Sam-Belliveau/fast-robots/README.md

# fast-robots
Website for hosting the lab assignments for ECE 4160 Fast Robots
