Sam-Belliveau/fast-robots/index.markdown

---
layout: home
title: Home
---

# ECE 4160: Fast Robots

<div style="display: flex; align-items: center; gap: 2rem; flex-wrap: wrap; margin-bottom: 1.5rem;">
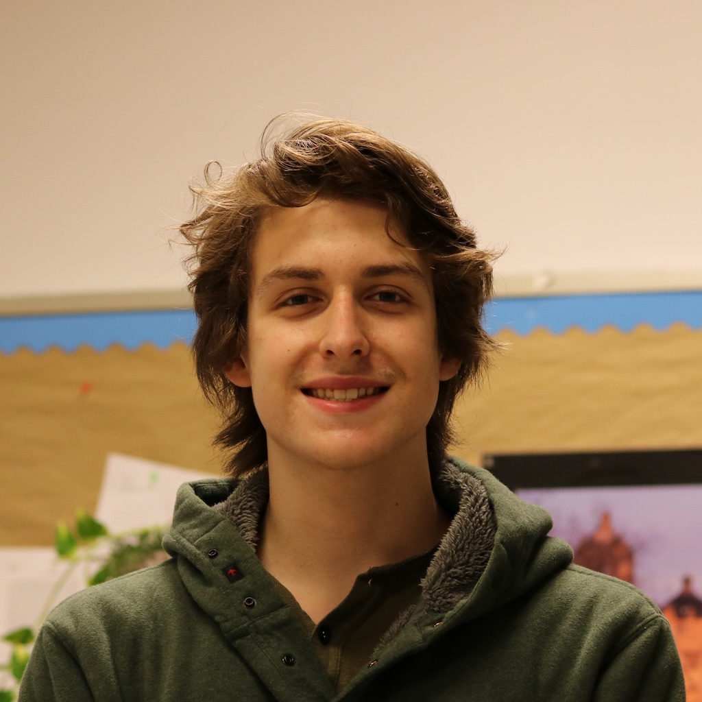
[picture p1: photos/SamBProfilePicture.jpg]
Sam Belliveau
  
  <div>
    <h2 style="margin: 0;">Sam Belliveau</h2>
    <p style="margin: 0.5rem 0;">Senior, Electrical & Computer Engineering</p>
    <p style="margin: 0;">Cornell University · Spring 2026</p>
  </div>
</div>

I'm a senior ECE major at Cornell doing HCI research. This site documents my journey through ECE 4160: Fast Robots, where I'm building and programming an autonomous robot.

🔗 **Personal Website:** [samb.nyc](https://samb.nyc)

## Labs

- [Lab 1: The Artemis Board and Bluetooth](labs/lab1/)
- [Lab 2: IMU](labs/lab2/)
- [Lab 3: ToF](labs/lab3/)
- [Lab 4: Motor Drivers and Open Loop Control](labs/lab4/)
- [Lab 5: Linear PID and Linear Interpolation](labs/lab5/)
- [Lab 6: Orientation PID](labs/lab6/)
- [Lab 7: Kalman Filtering](labs/lab7/)
- [Lab 8: Stunts!](labs/lab8/)
- [Lab 9: Mapping](labs/lab9/)
- [Lab 10: Localization (sim)](labs/lab10/)
- [Lab 11: Localization (real)](labs/lab11/)
- [Lab 12: Planning and Execution](labs/lab12/)

<!--
  -->
