Sam-Belliveau/fast-robots/labs/lab1/images/send_2_ints_ipynb.png

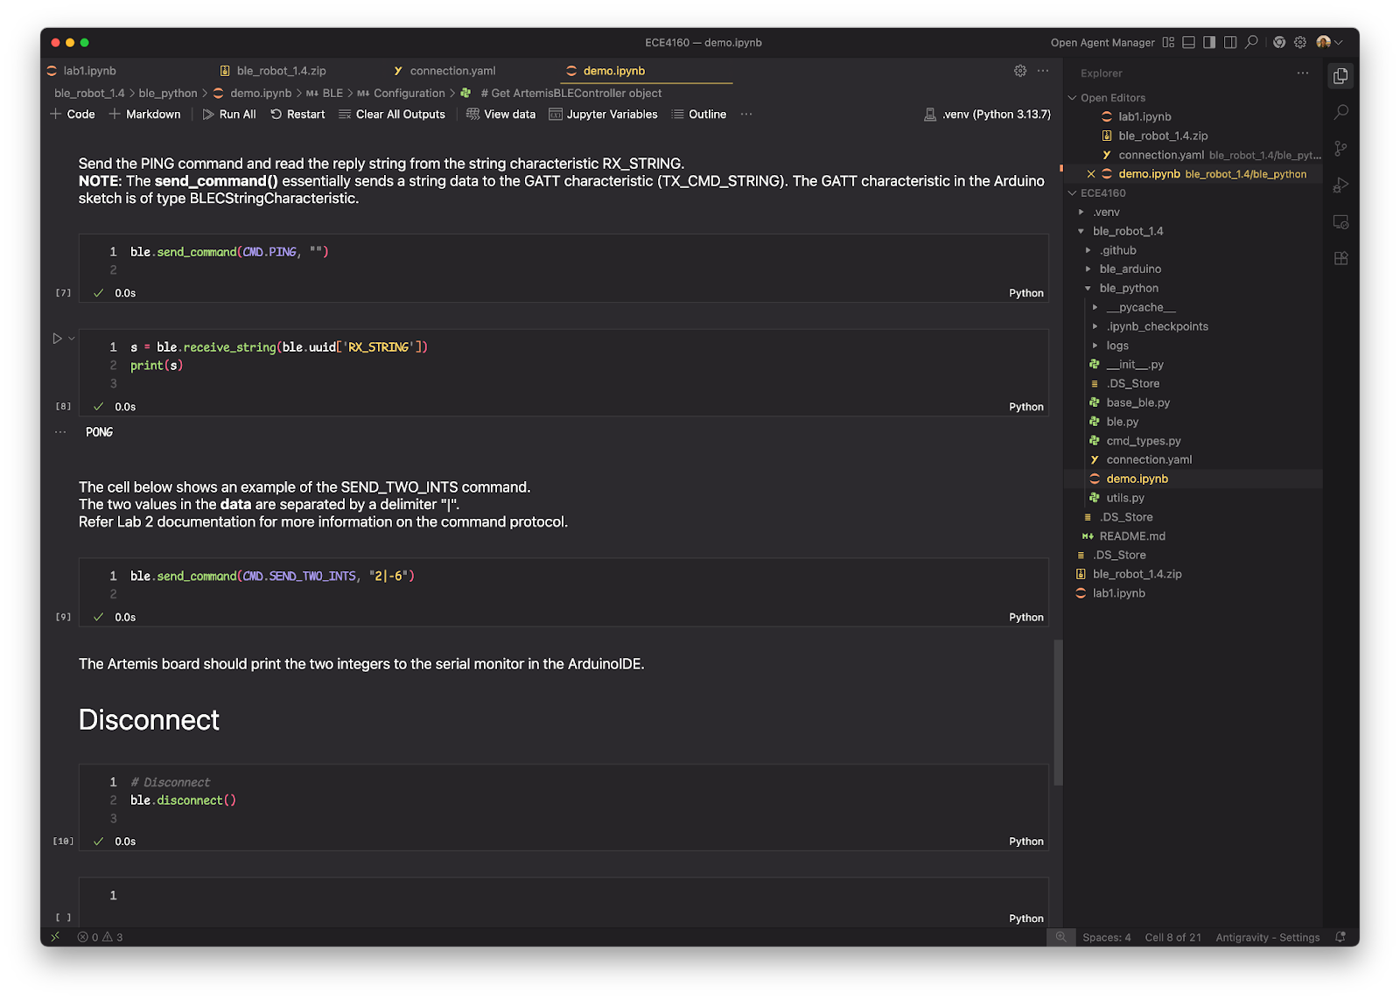
labs/lab1/images/send_2_ints_ipynb.png
