Sam-Belliveau/fast-robots/labs/lab3/images/tof_accuracy.png

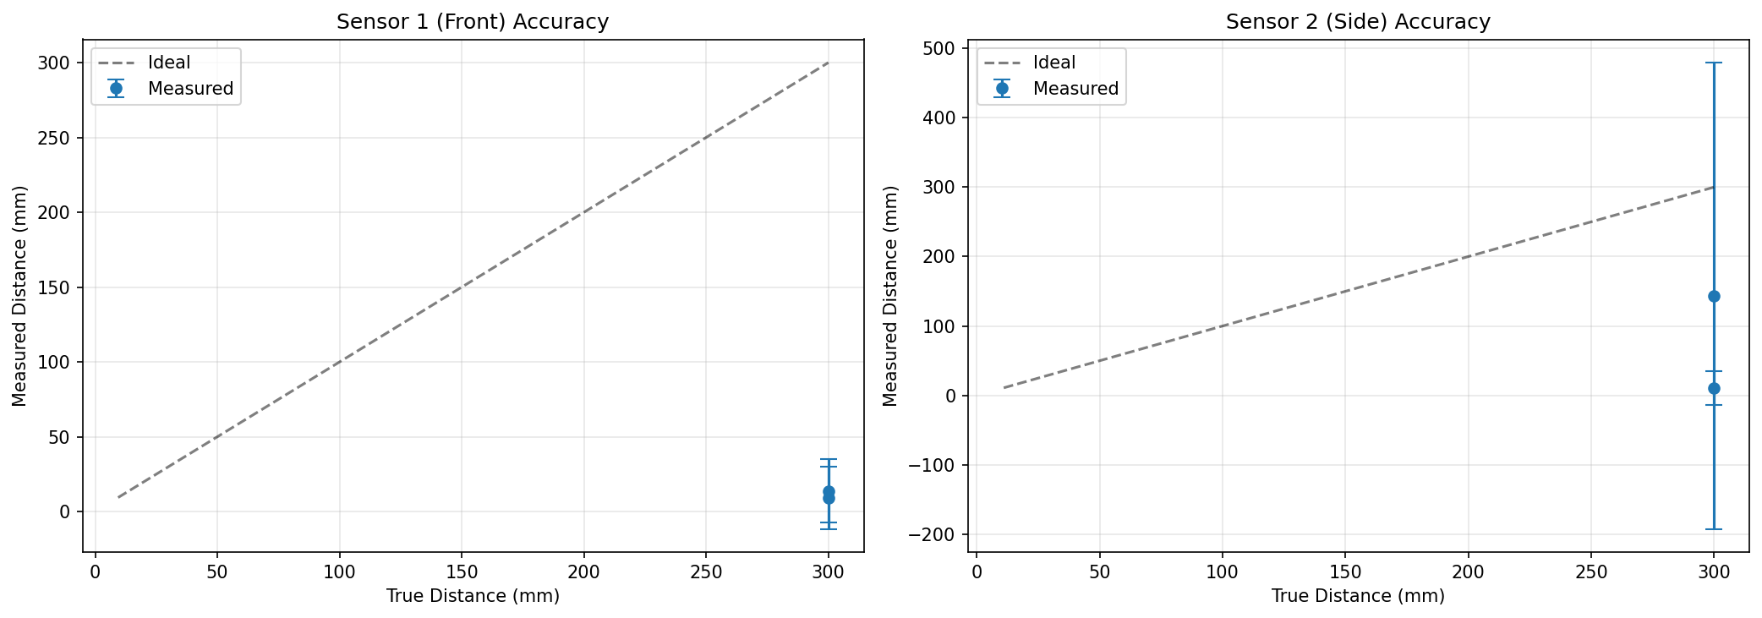
labs/lab3/images/tof_accuracy.png
