Sam-Belliveau/fast-robots/labs/lab3/images/tof_imu_combined.png

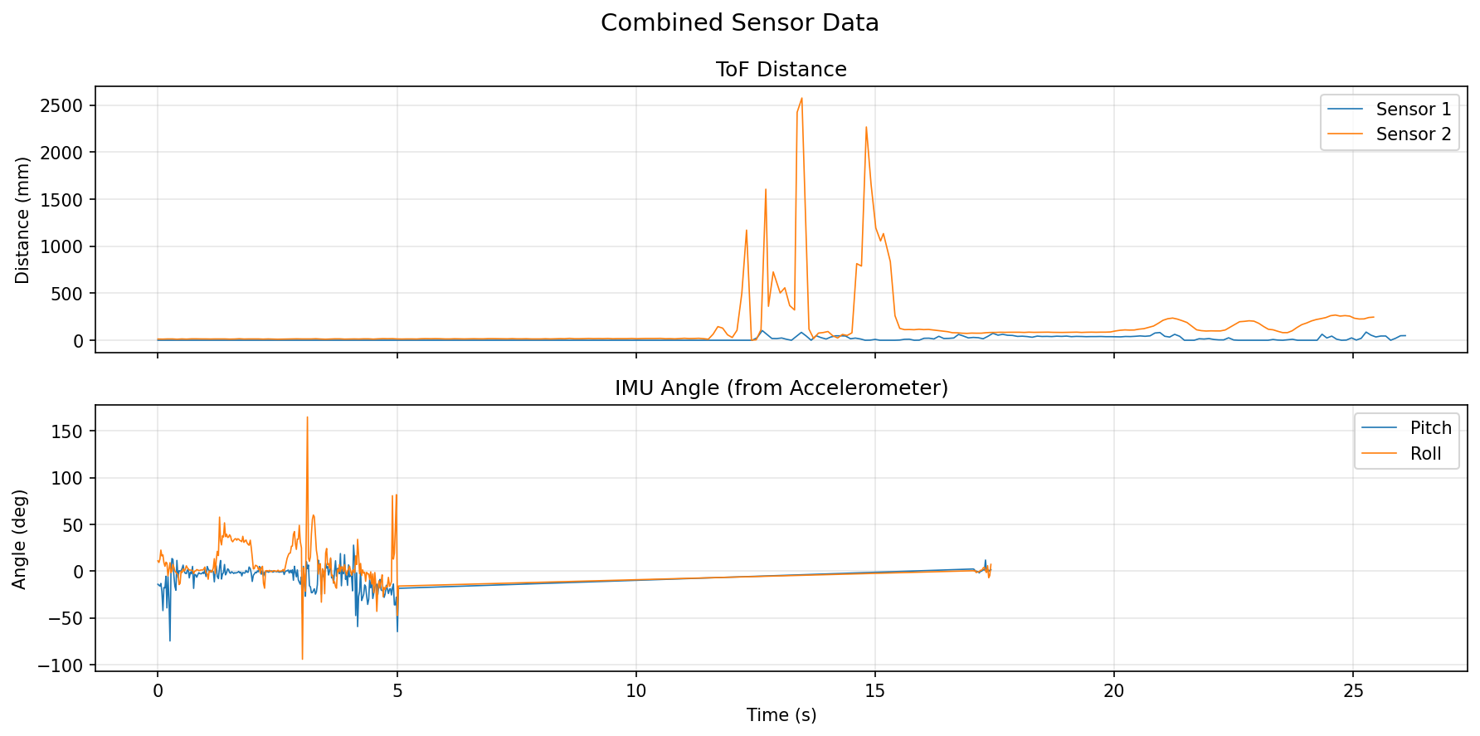
labs/lab3/images/tof_imu_combined.png
