Sam-Belliveau/fast-robots/labs/lab9/images/AngleMap1.png

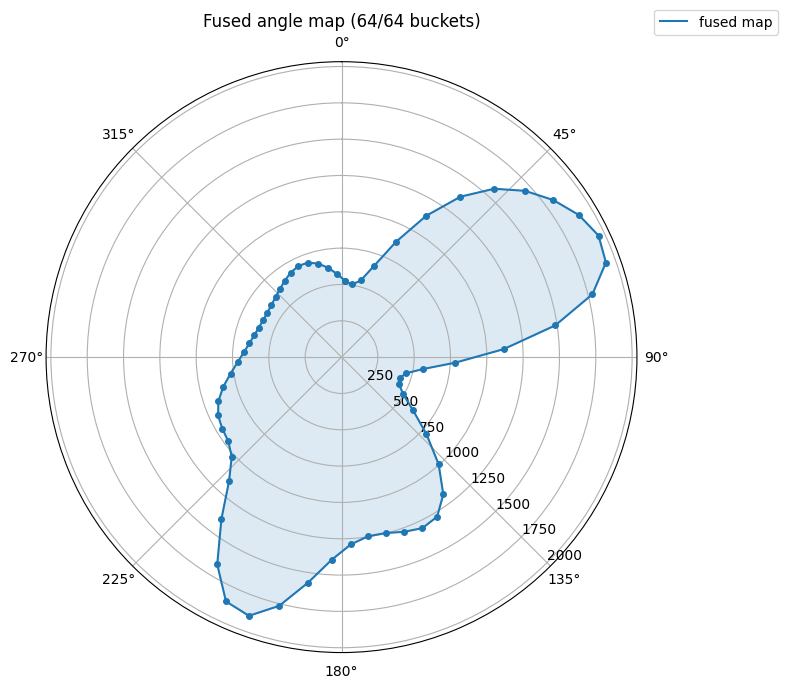
labs/lab9/images/AngleMap1.png
