Sam-Belliveau/fast-robots/labs/lab9/images/AngleMap2.png

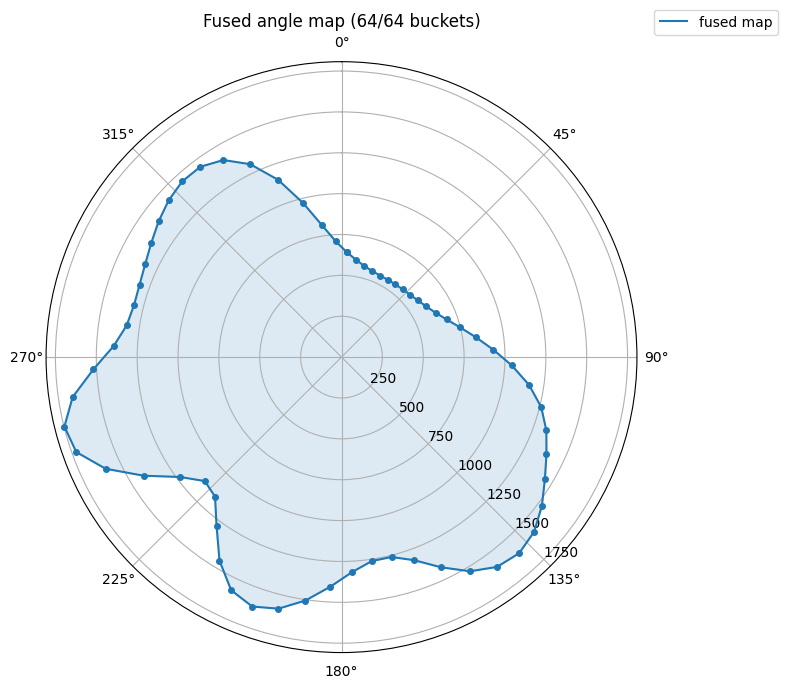
labs/lab9/images/AngleMap2.png
