Sam-Belliveau/fast-robots/labs/lab9/images/AngleMap3.png

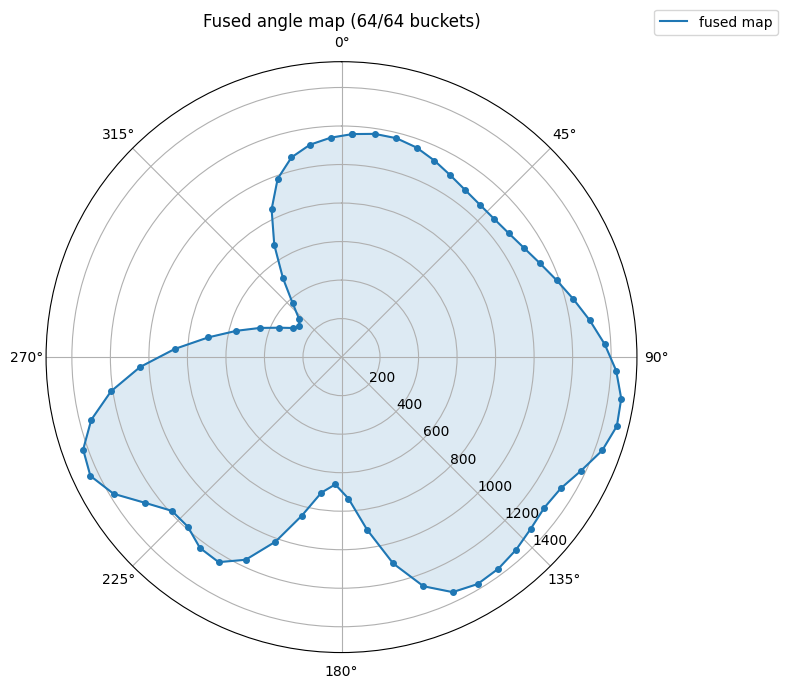
labs/lab9/images/AngleMap3.png
