Sam-Belliveau/fast-robots/labs/lab9/images/Arrows.png

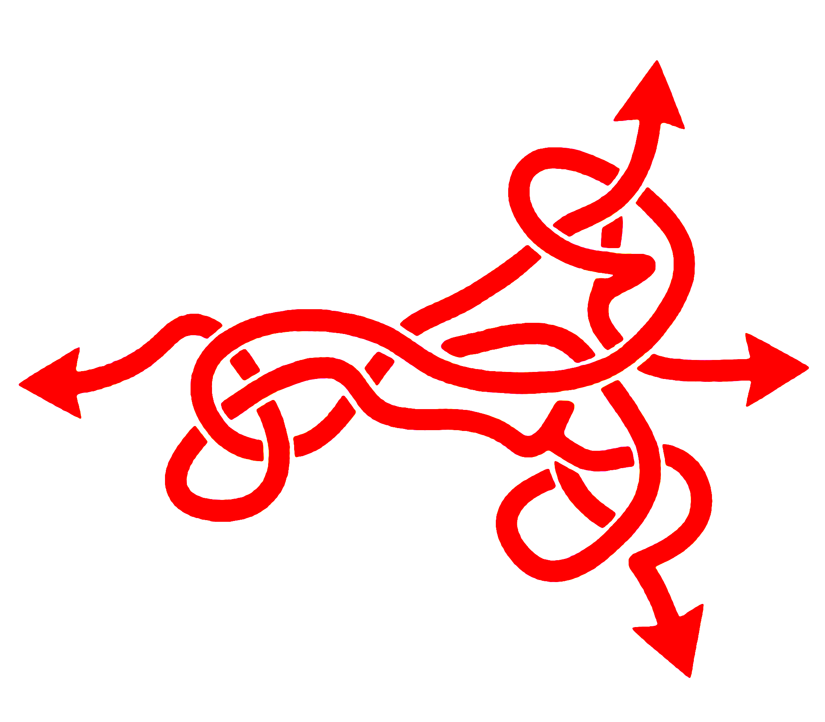
labs/lab9/images/Arrows.png
