Sam-Belliveau/fast-robots/labs/lab11/images/pose_1_heatmap.png

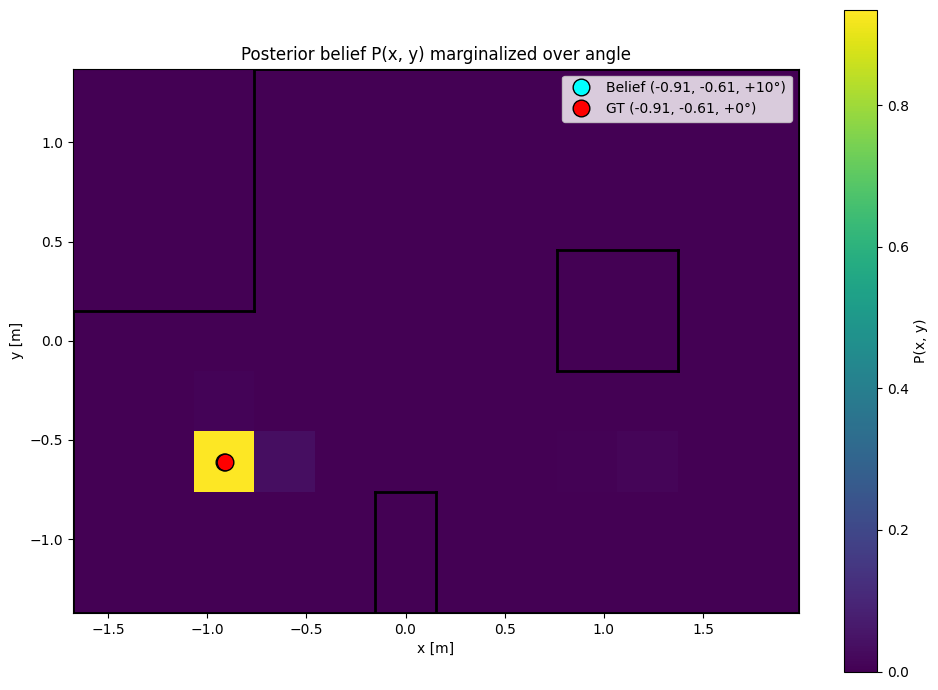
labs/lab11/images/pose_1_heatmap.png
