Sam-Belliveau/fast-robots/labs/lab11/images/pose_1_scan.png

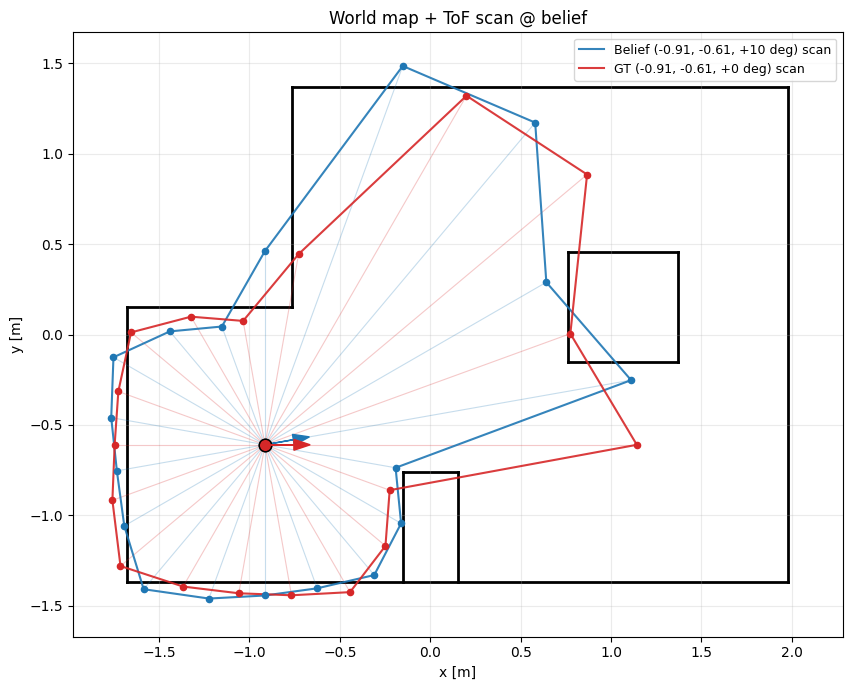
labs/lab11/images/pose_1_scan.png
