Sam-Belliveau/fast-robots/labs/lab11/images/pose_2_heatmap.png

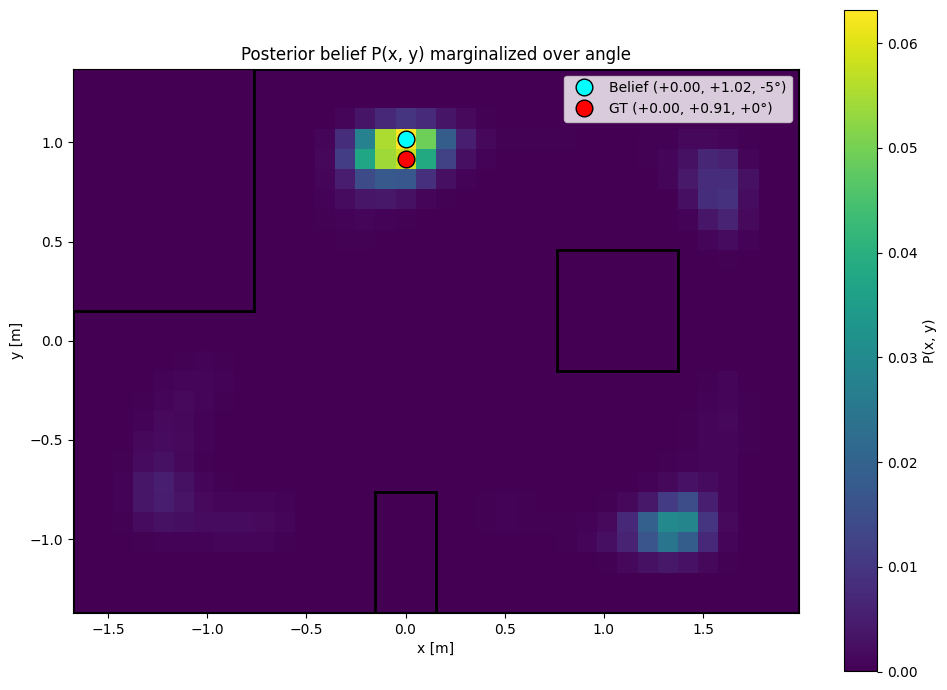
labs/lab11/images/pose_2_heatmap.png
