Sam-Belliveau/fast-robots/labs/lab11/images/pose_2_scan.png

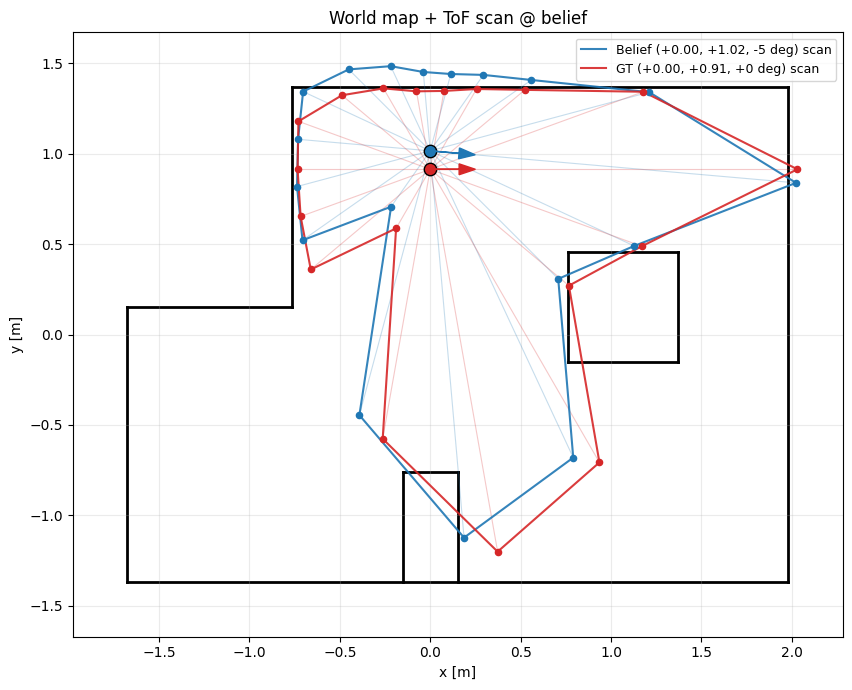
labs/lab11/images/pose_2_scan.png
