Sam-Belliveau/fast-robots/labs/lab11/images/pose_3_scan.png

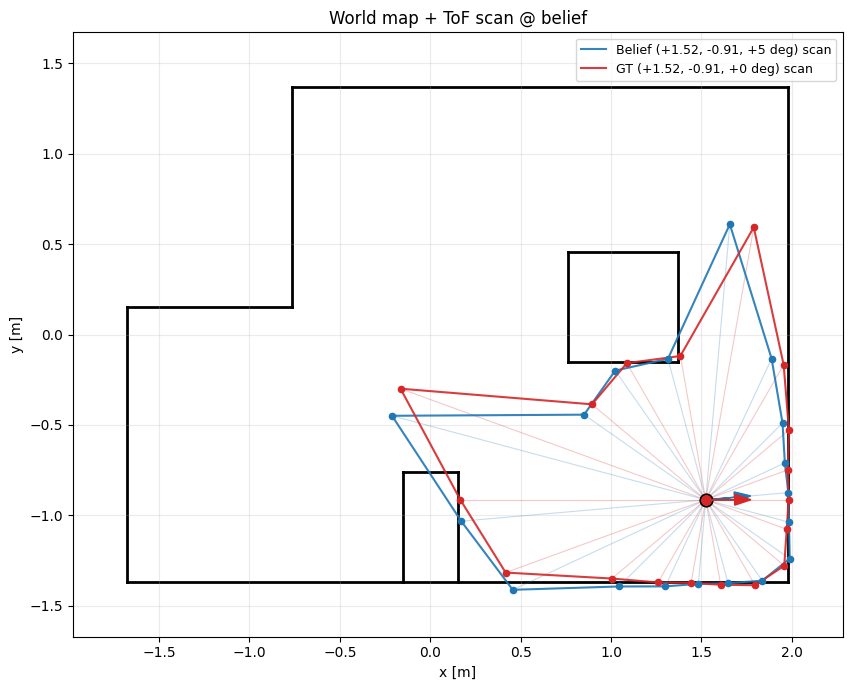
labs/lab11/images/pose_3_scan.png
