Sam-Belliveau/fast-robots/labs/lab11/images/pose_4_scan.png

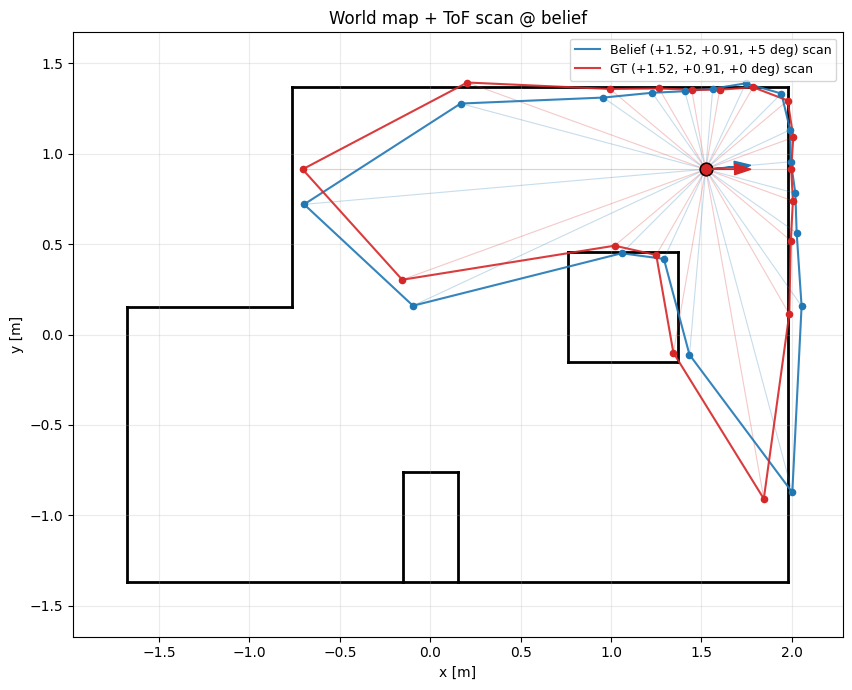
labs/lab11/images/pose_4_scan.png
