Sam-Belliveau/fast-robots/labs/lab3/images/tof_mode_comparison.pdf

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

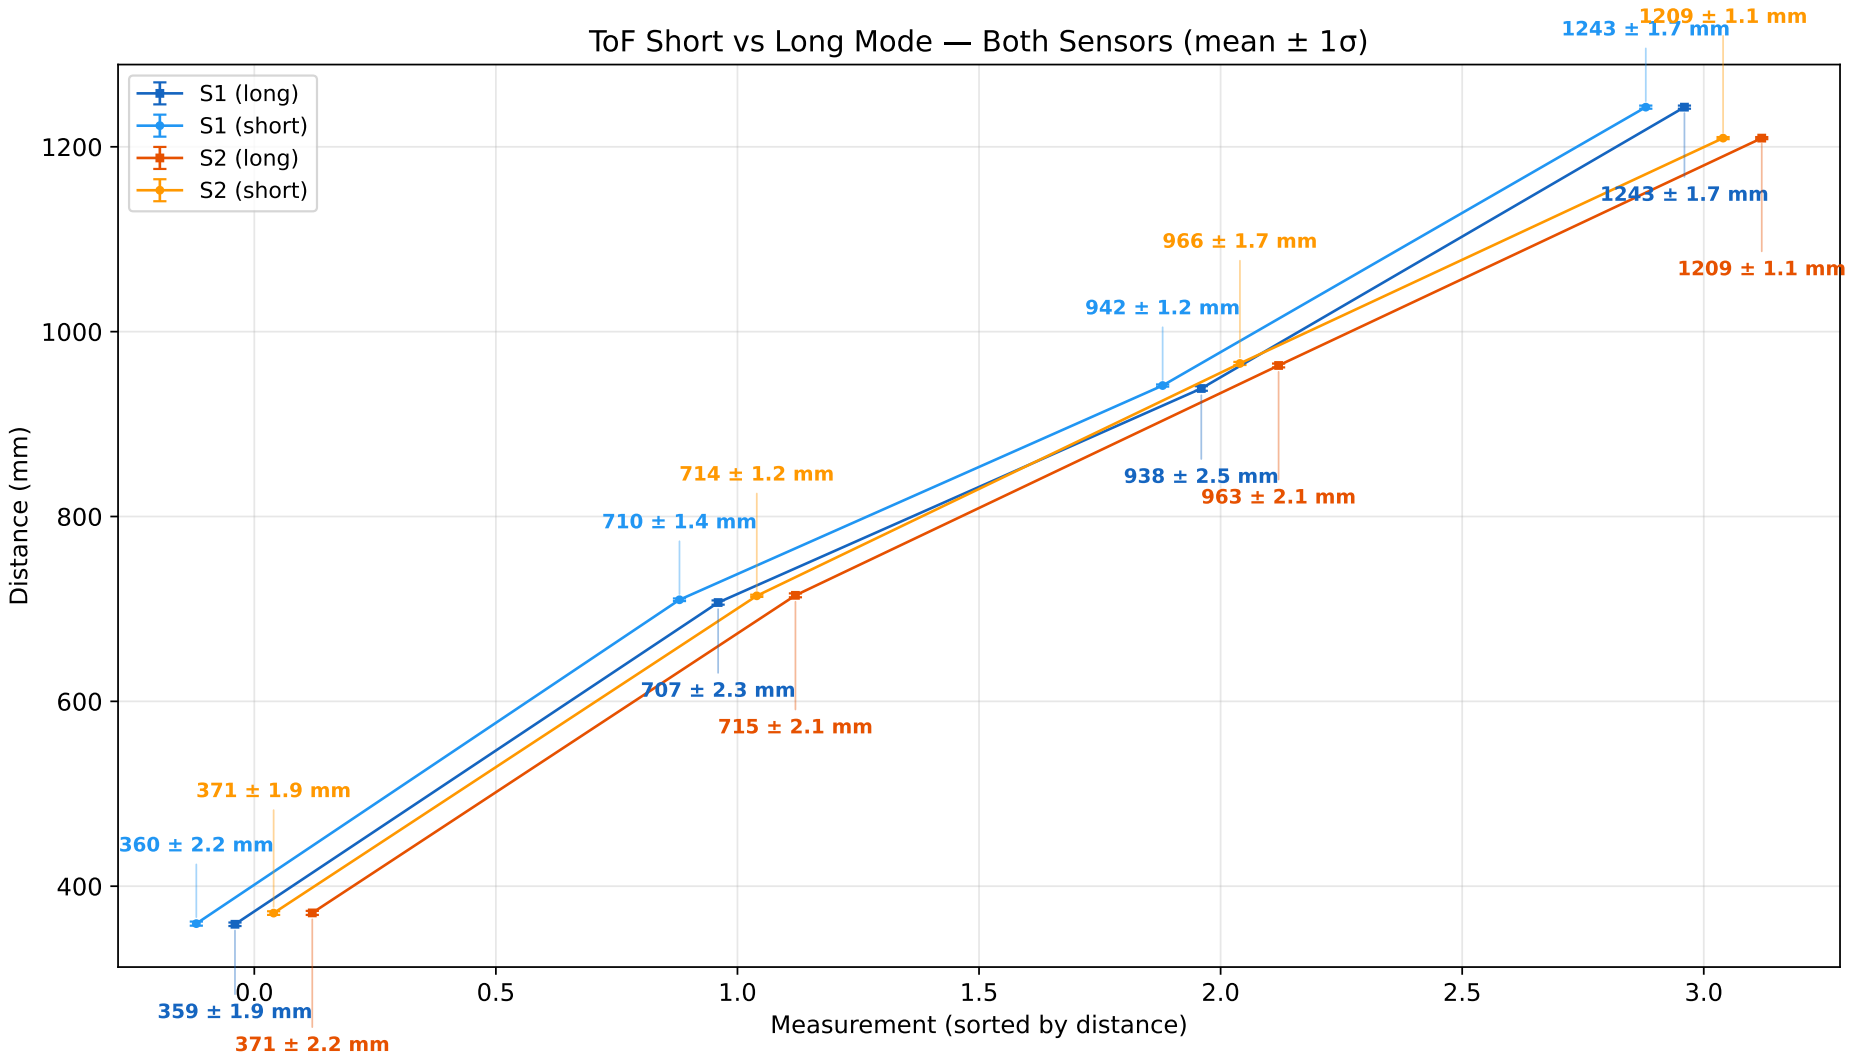
[picture p74: page 1]
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
