Sam-Belliveau/fast-robots/labs/lab12/ble_robot_1.4/main/subsystem_serial.h

#pragma once

// Serial output subsystem
// Toggle SERIAL_ENABLED to 0 to disable INFO output globally.
// ERROR output is always enabled regardless of this setting.

#define SERIAL_ENABLED 0

// ERROR_PRINT/LN: Always prints, regardless of SERIAL_ENABLED.
#define ERROR_PRINT(...) Serial.print(__VA_ARGS__)
#define ERROR_PRINTLN(...) Serial.println(__VA_ARGS__)

// INFO_PRINT/LN: Only prints when SERIAL_ENABLED is 1.
// Use for debug/status messages that can be disabled.
#if SERIAL_ENABLED
#define INFO_PRINT(...) Serial.print(__VA_ARGS__)
#define INFO_PRINTLN(...) Serial.println(__VA_ARGS__)
#else
#define INFO_PRINT(...) ((void)0)
#define INFO_PRINTLN(...) ((void)0)
#endif

namespace serial {

    void init() {
#if SERIAL_ENABLED
        Serial.begin(115200);
#endif
    }

} // namespace serial
