Sam-Belliveau/fast-robots/labs/lab12/ble_robot_1.4/main/lib_BLEPacket.h

#pragma once

// Binary BLE request/response protocol.
// Self-describing fields: each value is prefixed with a DataType tag byte.
// Packet format: [u16 req_id] [DT tag, value]... [DT_END]

#include <cstring>

#define MAX_MSG_SIZE 150

enum DataType : uint8_t {
    // Strings
    DT_STR = 0x00,

    // Signed Integers
    DT_I8 = 0x10,
    DT_I16 = 0x11,
    DT_I32 = 0x12,

    // Unsigned Integers
    DT_U8 = 0x20,
    DT_U16 = 0x21,
    DT_U32 = 0x22,

    // Floats
    DT_F32 = 0x30,

    // Special
    DT_ERR = 0xFE, // Error string: same encoding as DT_STR
    DT_END = 0xFF,
};

template <typename T> class DataTypeToID {};

#define DEFINE_TYPE_MAPPING(type, id)                                          \
    template <> struct DataTypeToID<type> {                                    \
        static const DataType value = id;                                      \
    };

DEFINE_TYPE_MAPPING(int8_t, DT_I8)
DEFINE_TYPE_MAPPING(int16_t, DT_I16)
DEFINE_TYPE_MAPPING(int32_t, DT_I32)
DEFINE_TYPE_MAPPING(uint8_t, DT_U8)
DEFINE_TYPE_MAPPING(uint16_t, DT_U16)
DEFINE_TYPE_MAPPING(uint32_t, DT_U32)
DEFINE_TYPE_MAPPING(float, DT_F32)

#undef DEFINE_TYPE_MAPPING

// Defined in subsystem_ble.h. Sends raw bytes over the TX characteristic.
void ble_send_raw(const uint8_t *data, uint8_t len);

// TX: builds and sends self-describing binary packets.
// Buffer auto-flushes when full. Only call end() to finalize.
struct BLEResponse {
    uint8_t len;
    uint8_t buf[MAX_MSG_SIZE];

    // Numeric types: tag is resolved via DataTypeToID<T>.
    // Auto-flushes if the value would overflow the buffer.
    template <typename T, DataType id = DataTypeToID<T>::value>
    void add(const T &v) {
        if (len + 1 + (int)sizeof(T) > MAX_MSG_SIZE)
            flush();
        buf[len++] = id;
        memcpy(buf + len, &v, sizeof(T));
        len += sizeof(T);
    }

    // String specialization: DT_STR + u8 length + chars.
    // Auto-flushes if the string would overflow the buffer.
    void add(const char *s) {
        uint8_t slen = strlen(s);
        if (len + 2 + slen > MAX_MSG_SIZE)
            flush();
        buf[len++] = DT_STR;
        buf[len++] = slen;
        memcpy(buf + len, s, slen);
        len += slen;
    }

    // Send an error string. Uses DT_ERR tag so the client can distinguish
    // errors from normal string fields.
    void add_error(const char *s) {
        uint8_t slen = strlen(s);
        if (len + 2 + slen > MAX_MSG_SIZE)
            flush();
        buf[len++] = DT_ERR;
        buf[len++] = slen;
        memcpy(buf + len, s, slen);
        len += slen;
    }

    // Append DT_END and send. Call once at the end of a response.
    void end() {
        if (len + 1 > MAX_MSG_SIZE)
            flush();
        buf[len++] = DT_END;
        flush();
    }

  private:
    friend struct BLERequest;

    BLEResponse(uint16_t req_id) : len(0) {
        memcpy(buf, &req_id, 2);
        len = 2;
    }

    // Send the current buffer and reset for the next chunk (same req_id).
    void flush() {
        ble_send_raw(buf, len);
        len = 2; // keep req_id prefix
    }
};

template <typename T> T read_from_buffer(const uint8_t *data) {
    T v;
    memcpy(&v, data, sizeof(T));
    return v;
}

// RX: reads sequential typed values from a raw byte buffer.
// Constructor parses the header (req_id + cmd_id). Then call read<T>()
// for each argument.
struct BLERequest {
    const uint8_t *const data;
    const int total_len;
    const uint16_t req_id;
    const uint8_t cmd;
    mutable int pos;

    BLERequest(const uint8_t *d, int l)
        : data(d), total_len(l), req_id(read_from_buffer<uint16_t>(data)),
          cmd(d[2]), pos(3) {}

    // Create a response packet bound to this request's req_id.
    BLEResponse new_response() const {
        return BLEResponse(req_id);
    }

    // Numeric types: verify the type tag matches, then read sizeof(T) bytes.
    // Returns false on type mismatch or insufficient data.
    template <typename T, DataType id = DataTypeToID<T>::value>
    bool read(T &out) const {
        if (pos + 1 + (int)sizeof(T) > total_len) {
            ERROR_PRINT(F("read<"));
            ERROR_PRINT(id);
            ERROR_PRINT(F(">: unexpected end of request (need "));
            ERROR_PRINT(1 + (int)sizeof(T));
            ERROR_PRINT(F(" bytes, have "));
            ERROR_PRINT(total_len - pos);
            ERROR_PRINTLN(F(")"));
            return false;
        }
        DataType actual = (DataType)data[pos++];
        if (actual != id) {
            ERROR_PRINT(F("read<"));
            ERROR_PRINT(id);
            ERROR_PRINT(F(">: incorrect datatype (expected 0x"));
            ERROR_PRINT(id, HEX);
            ERROR_PRINT(F(", got 0x"));
            ERROR_PRINT(actual, HEX);
            ERROR_PRINTLN(F(")"));
            return false;
        }
        memcpy(&out, data + pos, sizeof(T));
        pos += sizeof(T);
        return true;
    }

    // String: verify DT_STR tag, read u8 length, copy chars.
    // Returns length of string, or -1 on failure.
    int read_str(char *out) const {
        if (pos + 2 > total_len) {
            ERROR_PRINTLN(
                F("read_str: unexpected end of request")
            );
            return -1;
        }
        DataType actual = (DataType)data[pos++];
        if (actual != DT_STR) {
            ERROR_PRINT(F("read_str: incorrect datatype (expected 0x"));
            ERROR_PRINT(DT_STR, HEX);
            ERROR_PRINT(F(", got 0x"));
            ERROR_PRINT(actual, HEX);
            ERROR_PRINTLN(F(")"));
            return -1;
        }
        uint8_t slen = data[pos++];
        if (pos + slen > total_len) {
            ERROR_PRINT(F("read_str: string truncated (declared "));
            ERROR_PRINT(slen);
            ERROR_PRINT(F(" bytes, have "));
            ERROR_PRINT(total_len - pos);
            ERROR_PRINTLN(F(")"));
            return -1;
        }
        memcpy(out, data + pos, slen);
        out[slen] = '\0';
        pos += slen;
        return slen;
    }
};
