Sam-Belliveau/fast-robots/labs/lab12/ble_robot_1.4/main/lib_Zip.h

#pragma once

#include <utility>

template <typename Iterator> inline void advance_all(Iterator &iterator) {
  ++iterator;
}

template <typename Iterator, typename... Iterators>
inline void advance_all(Iterator &iterator, Iterators &...iterators) {
  ++iterator;
  advance_all(iterators...);
}

template <typename Function, typename Iterator, typename... Iterators>
inline Function zip(Function &&func, Iterator begin, Iterator end,
                    Iterators... iterators) {
  for (; begin != end; ++begin, advance_all(iterators...))
    func(*begin, *(iterators)...);
  return std::forward<Function>(func);
}
