Sam-Belliveau/fast-robots/labs/lab12/ble_robot_1.4/main_python_gui/__main__.py

"""Entry point: python -m main_python_gui"""

import asyncio

from aiohttp import web

from .bridge import BLEBridge
from .server import create_app


async def main():
    bridge = BLEBridge()

    app = create_app(bridge)
    runner = web.AppRunner(app)
    await runner.setup()
    site = web.TCPSite(runner, "127.0.0.1", 8080)
    await site.start()
    print("Running on http://127.0.0.1:8080")
    print("Press Ctrl+C to quit")

    bridge.start()  # begin scanning for robot in background

    try:
        await asyncio.Event().wait()
    finally:
        await bridge.disconnect()
        await runner.cleanup()


asyncio.run(main())
