Sam-Belliveau/fast-robots/(commit log)

2026-02-09 Lab 2 Data
    [accelerometer.csv, filtered_accelerometer.csv]
2026-03-01 Add logging utility with colored output and file rotation
    [accelerometer.csv, filtered_accelerometer.csv]
2026-03-03 Lab 3
    [tof_results.csv]
2026-03-03 Initial Version of Lab 4 code
    [accelerometer.csv, filtered_accelerometer.csv, tof_results.csv]
2026-03-10 Add final assembly image and update lab4 documentation
2026-03-10 add lab 5 code
    [accelerometer.csv, filtered_accelerometer.csv, tof_results.csv]
2026-03-11 Refactor BLE command responses to use `end()` instead of `flush()`
    [tof_results.csv]
2026-03-11 Enhance BLE error handling and reporting across subsystems
    [bridge.py, lib_BLEPacket.h, lib_Exceptions.h, subsystem_ble.h, subsystem_motors.h, subsystem_pid.h]
2026-03-12 feat: Add MOTOR_TEST command and implement motor testing functionality
2026-03-12 Simplify motor control logic
2026-03-12 Update motor control definitions and enhance PID tuning
2026-03-17 Update the PID
2026-03-17 fix: Adjust PID duration and update input values in HTML for tuning parameters
    [subsystem_pid.h]
2026-03-17 fix: Update descriptions for PID run plots to reflect accurate distances
2026-03-17 Initial Lab 6
    [accelerometer.csv, filtered_accelerometer.csv]
2026-03-17 Add Kalman filter subsystem and integrate with existing components
2026-03-17 feat: Add Angle PID control commands and integrate with IMU subsystem
2026-03-17 Init lab 7
    [accelerometer.csv, filtered_accelerometer.csv]
2026-03-24 Add Kalman Filter implementation and refactor serial logging
    [accelerometer.csv, filtered_accelerometer.csv]
2026-03-25 feat: Implement DeSticker motor controller and integrate with motors subsystem
2026-03-29 Refactor Kalman filter and PID control for improved performance
2026-04-07 feat: Integrate gamepad subsystem and update angle PID commands for relative setpoint control
2026-04-13 lab 9
    [AngleMap1.csv, AngleMap2.csv, AngleMap3.csv]
2026-04-24 Complete Lab 10
    [localization_stats.csv]
2026-05-05 Fix path coordinates in LAB_PATH_FT for smoother transition
    [controller.py, paths.py, world.yaml]
